tiefpunkt/4bitsynth/images/building.jpg

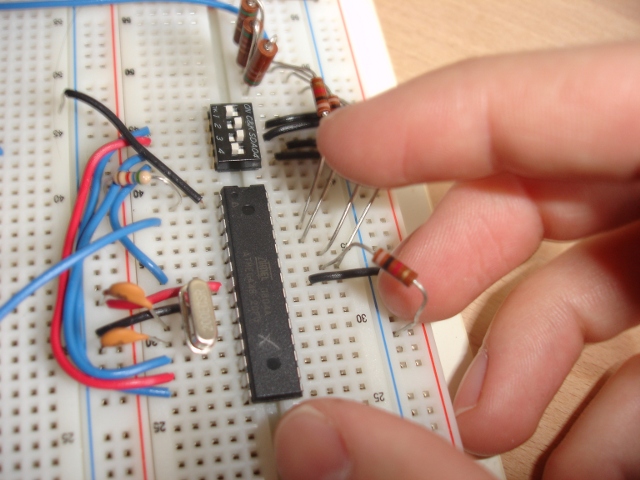
images/building.jpg
