tiefpunkt/4bitsynth/images/multipleexample.png

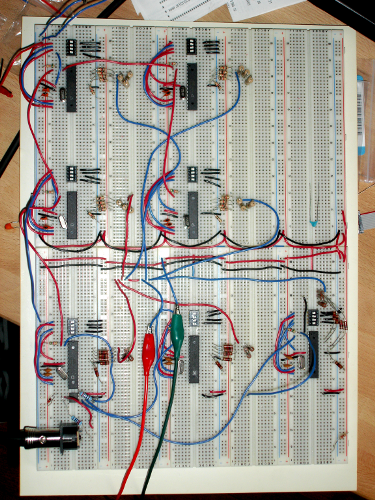
images/multipleexample.png
