tiefpunkt/4bitsynth/images/1.png

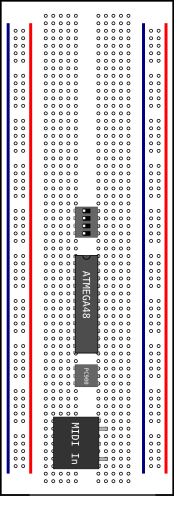
images/1.png
