tiefpunkt/4bitsynth/images/3.png

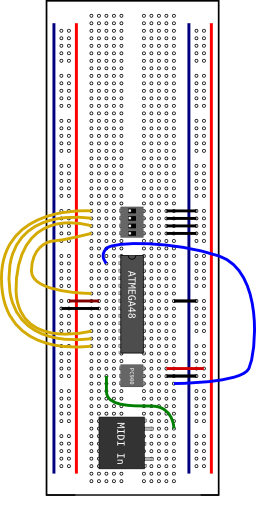
images/3.png
