tiefpunkt/4bitsynth/images/4.png

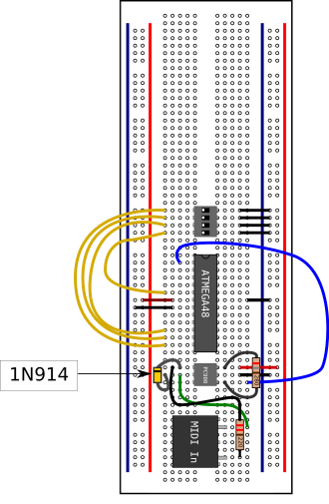
images/4.png
