tiefpunkt/4bitsynth/images/6.png

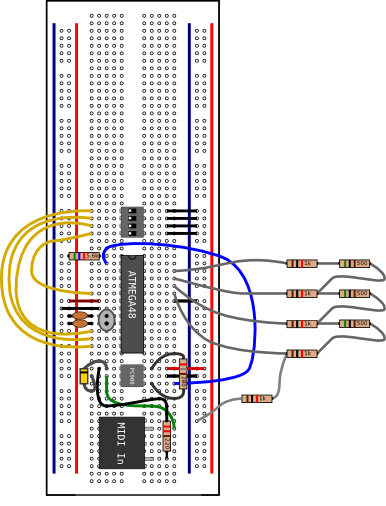
images/6.png
