tiefpunkt/4bitsynth/images/7.png

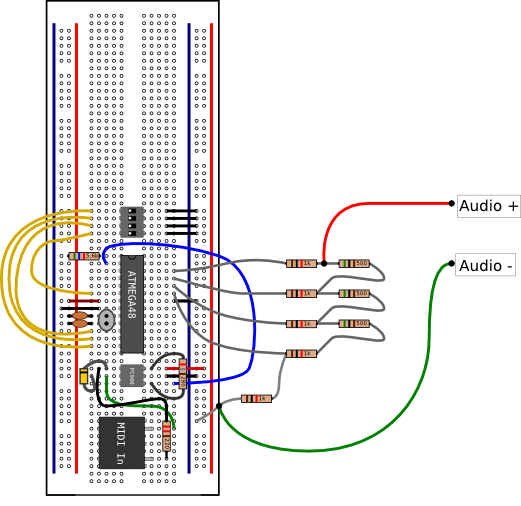
images/7.png
