tiefpunkt/4bitsynth/images/multiple.png

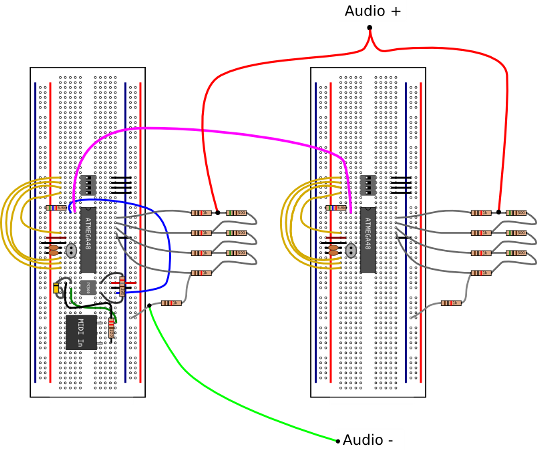
images/multiple.png
