tiefpunkt/4bitsynth/schematic/4bitschematic.pdf

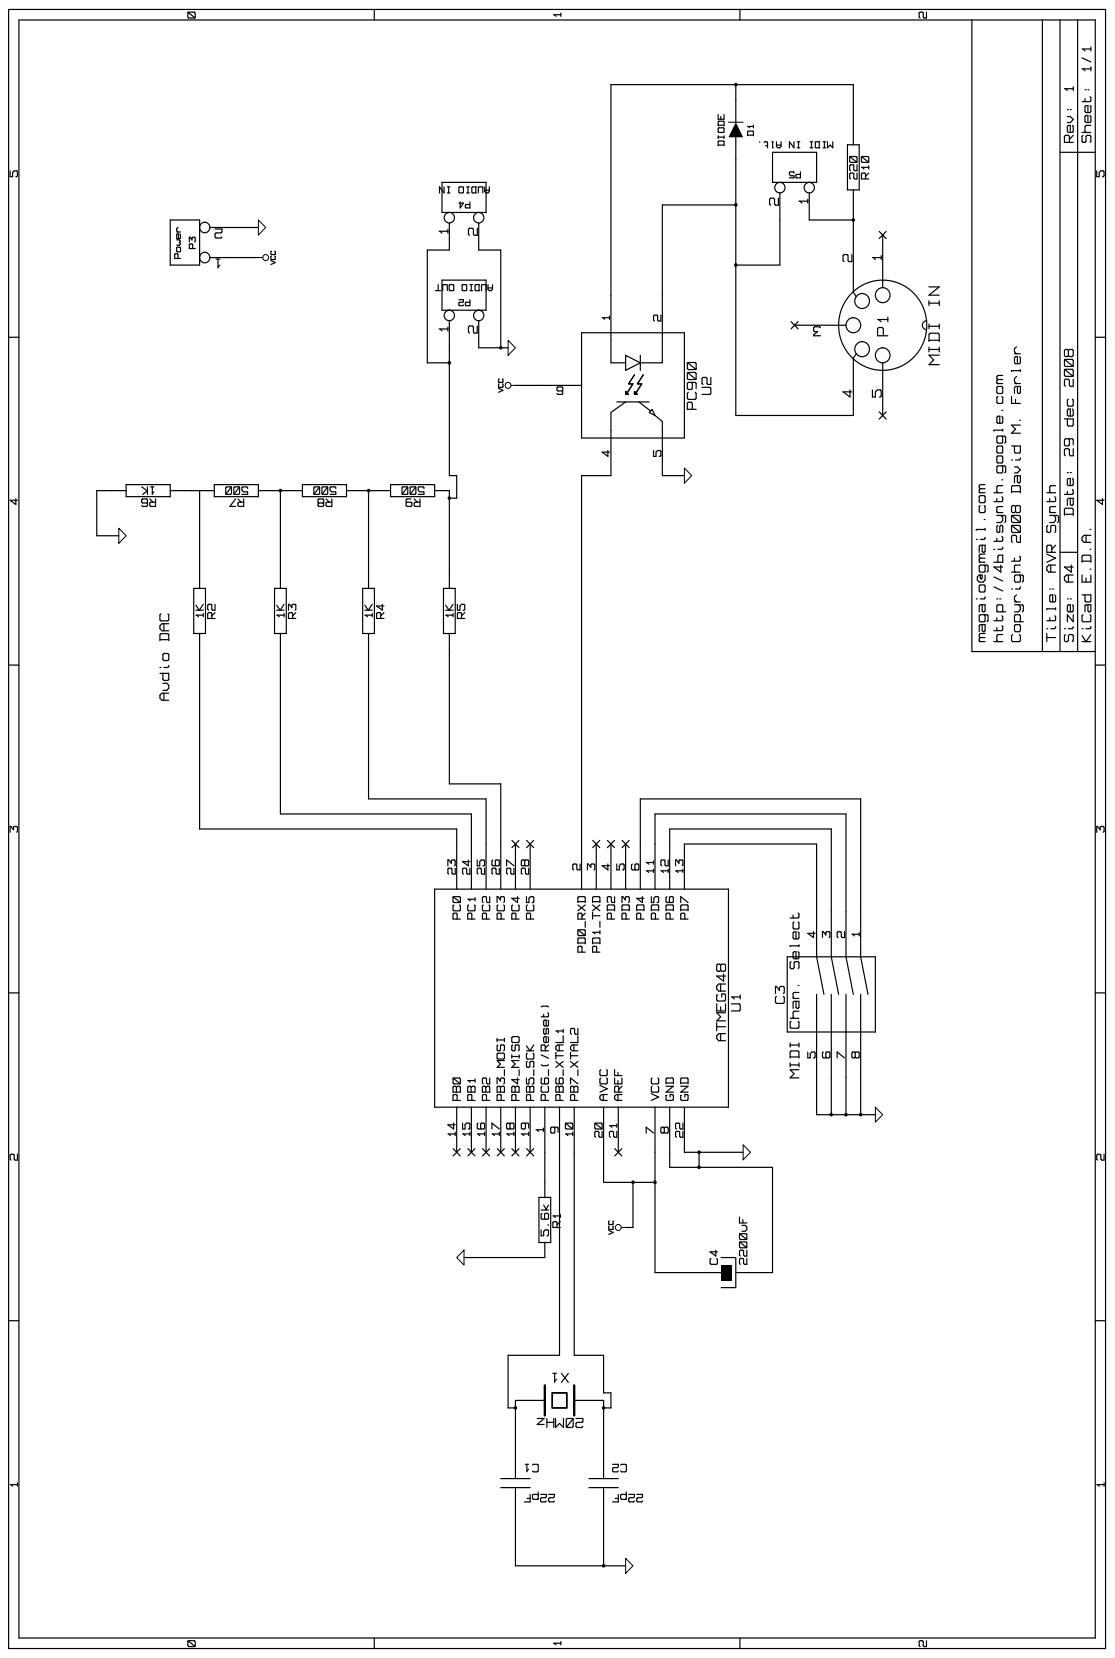
[picture p9: page 1]
