tiefpunkt/4bitsynth/schematic/AVRSynth.sch

## KiCad design schematic/AVRSynth.sch (2009-01-10, an earlier design)

Schematic: AVRSynth.sch

Parts:
C1, C2: 22pF
C3: MIDI Chan. Select
C4: 2200uF
D1: DIODE
P1: MIDI IN
P2: AUDIO OUT
P3: Power
P4: AUDIO IN
P5: MIDI IN Alt.
R1: 5.6k
R2, R3, R4, R5, R6: 1K
R7, R8, R9: 500
R10: 220
U1: ATMEGA48
U2: PC900
X1: 20MHz

Notes on the sheet:
Audio DAC
