tiefpunkt/4bitsynth/(commit log)

2009-01-02 First upload
    [AVRSynth.brd, AVRSynth.sch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]
2009-01-02 Added PDF of schematic
2009-01-02 added multiple synth circuit diagram multiple.png
2009-01-10 Updated schematic PDF with current contact information and website
2009-01-10 Changes to contact info on kicad schematic file
    [AVRSynth.sch]
